NipunDilshanSenevirathne/Agnikarma-Device-Medi-/hardware/fabrication/P3R1/drill-report.txt

Drill report for agni-controller-carrier.kicad_pcb
Created on 2026-10-31T03:52:27

Copper Layer Stackup:
    =============================================================
    L1 :  F.Cu                      front
    L2 :  B.Cu                      back

Drill file 'agni-controller-carrier-PTH.drl' contains
    plated through holes:
    =============================================================
    T1  1.000mm  0.0394"  (160 holes))
    T2  1.300mm  0.0512"  (2 holes))

    Total plated holes count 162

Drill file 'agni-controller-carrier-NPTH.drl' contains
    unplated through holes:
    =============================================================
    T1  3.200mm  0.1260"  (4 holes))

    Total unplated holes count 4
