NipunDilshanSenevirathne/Agnikarma-Device-Medi-/docs/audit-sources.md

# Primary sources checked in the audit - 31 October 2026
- [Adafruit MAX31865 pinout and terminal guide](https://learn.adafruit.com/adafruit-max31865-rtd-pt100-amplifier/pinouts): four-wire terminal configuration and module supply/output distinction.
- [Adafruit OLED wiring guide](https://learn.adafruit.com/monochrome-oled-breakouts/wiring-128x64-oleds): current STEMMA QT auto-reset revision versus older reset-dependent hardware.
- [MicroPython 1.26 RP2 reference](https://docs.micropython.org/en/v1.26.0/rp2/quickref.html): target API context; no claim of target-board execution.

Other component, clinical and standards references are listed in sources.md. Catalogue/datasheet review does not establish whole-device safety or manufacturing correctness. Separate native CAD results are recorded in docs/records/native-cad-checks.json. Full licensed-standards assessment and physical tests have not been completed.
