NipunDilshanSenevirathne/Agnikarma-Device-Medi-/docs/delivery-status.md

# Delivery status 0.5.0

The folder now includes routed native carrier CAD, matching local libraries and schematic, native ERC/DRC/parity reports, candidate fabrication data, native board images, STEP and eight closed STL meshes. This closes the earlier absence of routing and native CAD checks for the **low-current carrier only**.

It does not close external circuit validation, fabrication/physical fit, real Pico execution, full cartridge construction, battery/charger selection, complete handheld packaging or medical release. Read [BUILD_COMPLETENESS](../BUILD_COMPLETENESS.md) and [engineering handover](engineering-handover.md). No physical test or approval is claimed as performed.
