NipunDilshanSenevirathne/Agnikarma-Device-Medi-/hardware/calculations/nichrome-arithmetic-NOT-a-winding-release.csv

Diameter_mm | Area_mm2 | Nominal_cold_length_mm | Wire_surface_cm2 | Full_on_surface_load_W_per_cm2_at_8p4V
0.15 | 0.017671 | 35.667 | 0.16808 | 190.821
0.2 | 0.031416 | 63.408 | 0.39841 | 80.503
0.25 | 0.049087 | 99.075 | 0.77814 | 41.217
0.3 | 0.070686 | 142.669 | 1.34462 | 23.853
0.35 | 0.096211 | 194.188 | 2.13521 | 15.021
0.4 | 0.125664 | 253.633 | 3.18725 | 10.063
