NipunDilshanSenevirathne/Agnikarma-Device-Medi-/hardware/calculations/power-envelope.csv

Voltage_V | Resistance_ohm | On_current_A | Full_on_power_W | Command_duty_limit | Actual_average_W_at_command_limit
6.2 | 1.98 | 3.1313 | 19.4141 | 0.5 | 9.7071
6.2 | 2.2 | 2.8182 | 17.4727 | 0.5 | 8.7364
6.2 | 2.42 | 2.562 | 15.8843 | 0.5 | 7.9421
7.4 | 1.98 | 3.7374 | 27.6566 | 0.5 | 13.8283
7.4 | 2.2 | 3.3636 | 24.8909 | 0.5 | 12.4455
7.4 | 2.42 | 3.0579 | 22.6281 | 0.5 | 11.314
8.4 | 1.98 | 4.2424 | 35.6364 | 0.5 | 17.8182
8.4 | 2.2 | 3.8182 | 32.0727 | 0.5 | 16.0364
8.4 | 2.42 | 3.4711 | 29.157 | 0.5 | 14.5785
8.5 | 1.98 | 4.2929 | 36.4899 | 0.5 | 18.2449
8.5 | 2.2 | 3.8636 | 32.8409 | 0.5 | 16.4205
8.5 | 2.42 | 3.5124 | 29.8554 | 0.5 | 14.9277
