NipunDilshanSenevirathne/Agnikarma-Device-Medi-/mechanical/exports/harness-clamp.stl

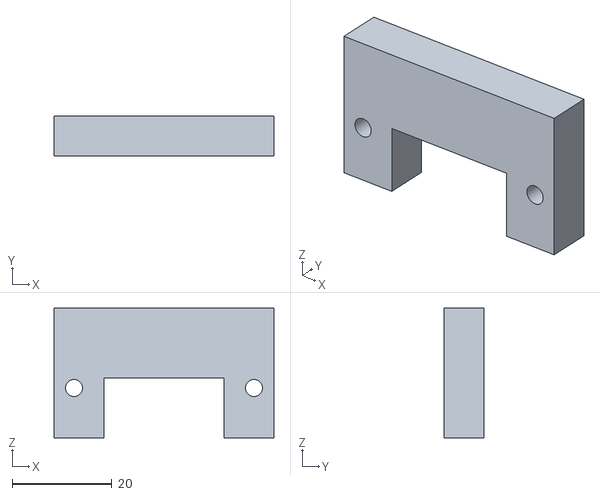
[picture p10: CAD file, 2026-10-30]
mechanical/exports/harness-clamp.stl
44.0 x 8.00 x 26.0
