NipunDilshanSenevirathne/Agnikarma-Device-Medi-/mechanical/exports/T03-shape.stl

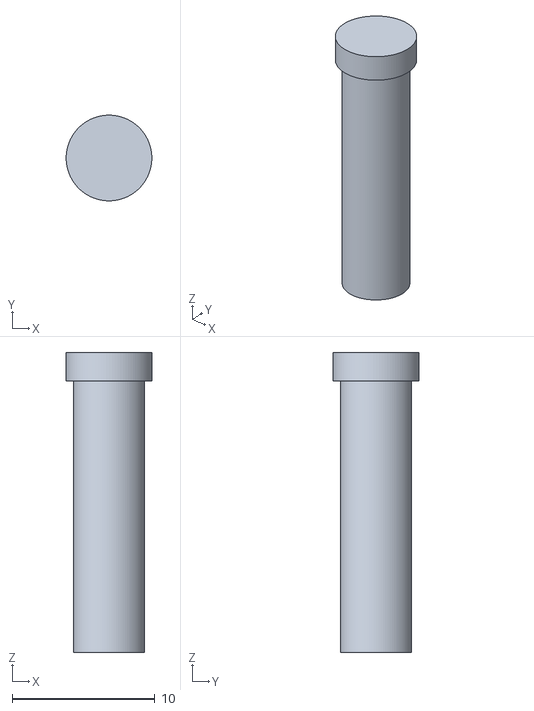
[picture p11: CAD file, 2026-10-30]
mechanical/exports/T03-shape.stl
6.00 x 6.00 x 21.0
