NipunDilshanSenevirathne/Agnikarma-Device-Medi-/mechanical/exports/T01-shape.stl

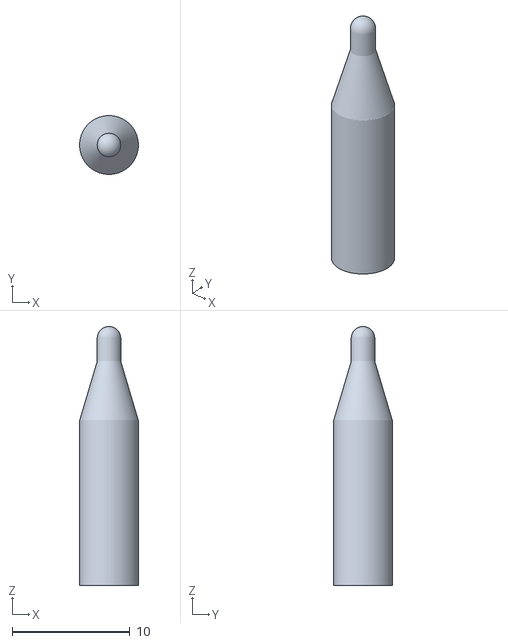
[picture p12: CAD file, 2026-10-30]
mechanical/exports/T01-shape.stl
5.00 x 5.00 x 22.0
