NipunDilshanSenevirathne/Agnikarma-Device-Medi-/mechanical/exports/T04-shape.stl

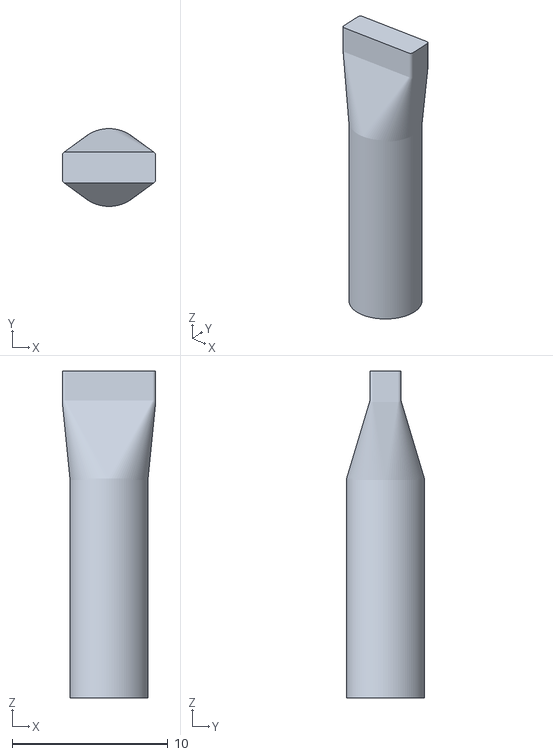
[picture p13: CAD file, 2026-10-30]
mechanical/exports/T04-shape.stl
6.00 x 5.00 x 21.0
