NipunDilshanSenevirathne/Agnikarma-Device-Medi-/mechanical/exports/carrier-board-only.step

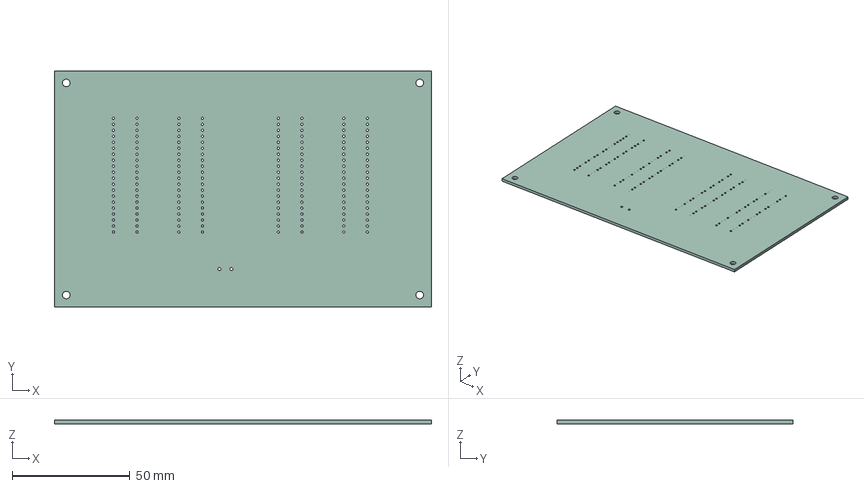
[picture p14: CAD file, 2026-10-30]
mechanical/exports/carrier-board-only.step
160.0 x 100.0 x 1.51 mm
