NipunDilshanSenevirathne/Agnikarma-Device-Medi-/mechanical/exports/T02-shape.stl

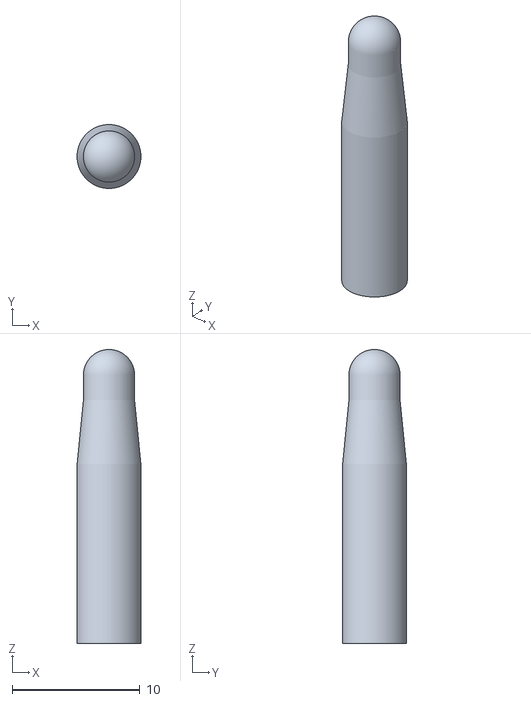
[picture p15: CAD file, 2026-10-30]
mechanical/exports/T02-shape.stl
5.00 x 5.00 x 23.0
