NipunDilshanSenevirathne/Agnikarma-Device-Medi-/mechanical/exports/controller-lid.stl

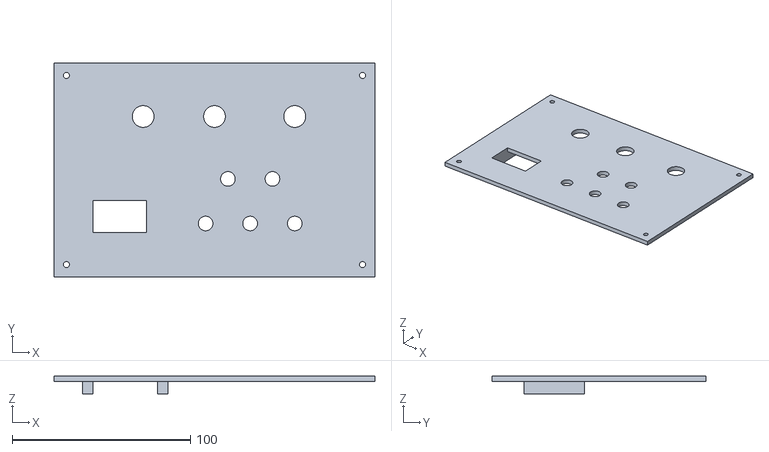
[picture p16: CAD file, 2026-10-30]
mechanical/exports/controller-lid.stl
180.0 x 120.0 x 10.0
