NipunDilshanSenevirathne/Agnikarma-Device-Medi-/mechanical/exports/T05-shape.stl

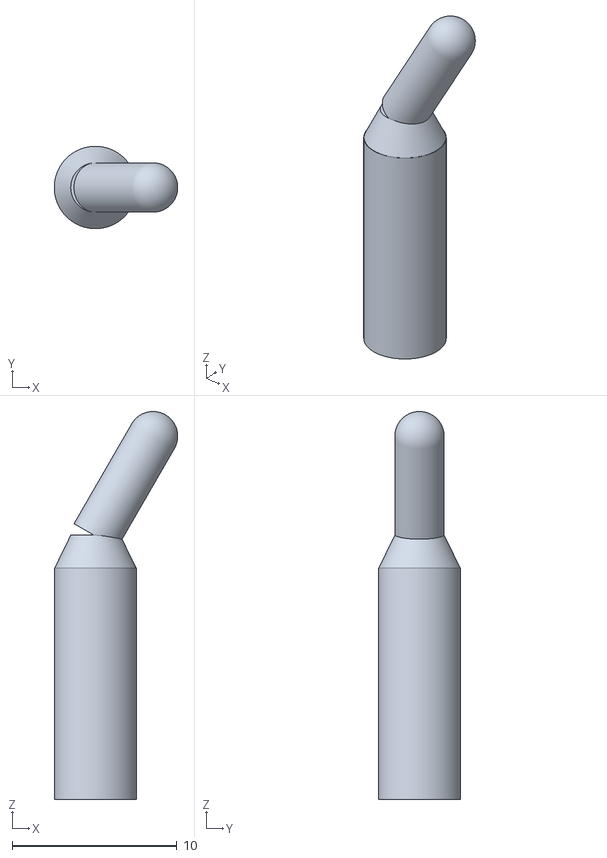
[picture p17: CAD file, 2026-10-30]
mechanical/exports/T05-shape.stl
7.50 x 5.00 x 23.6
