NipunDilshanSenevirathne/Agnikarma-Device-Medi-/mechanical/exports/controller-base.stl

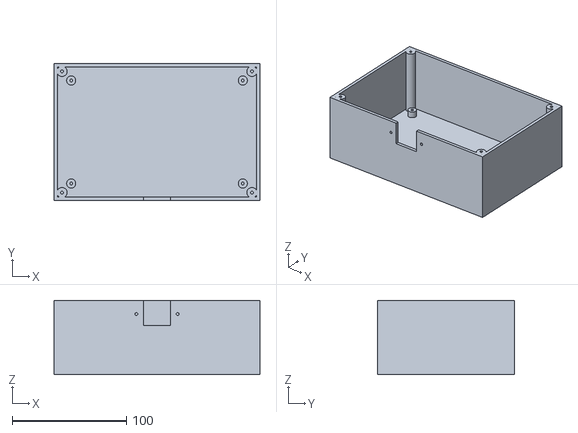
[picture p18: CAD file, 2026-10-30]
mechanical/exports/controller-base.stl
180.0 x 120.0 x 65.0
