NipunDilshanSenevirathne/Agnikarma-Device-Medi-/docs/images/terminal-wiring.png

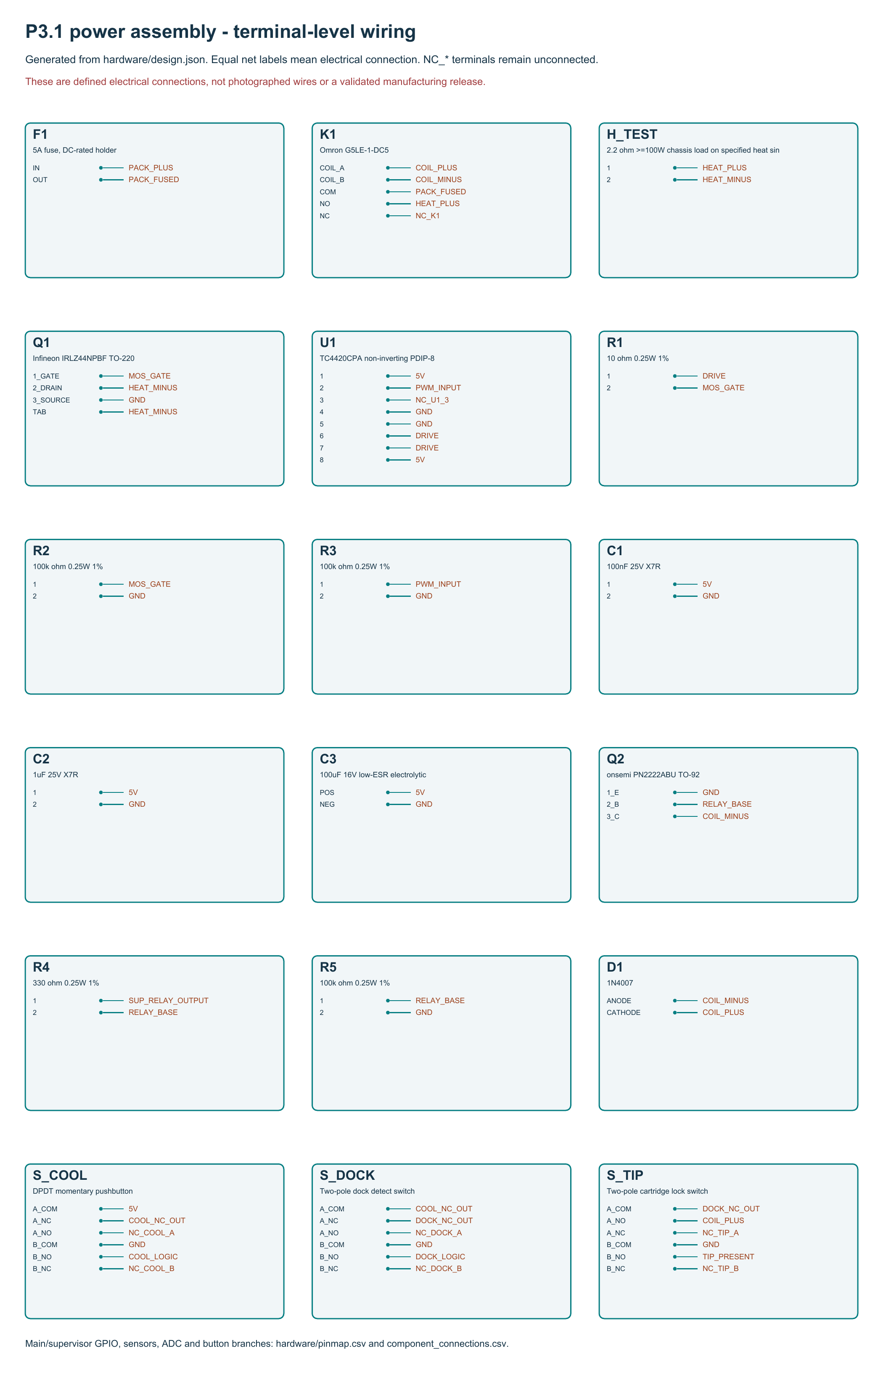
docs/images/terminal-wiring.png
