NipunDilshanSenevirathne/Agnikarma-Device-Medi-/docs/records/calibration-template.csv

record_id | date | unit_id | role | tip_id | reference_instrument | reference_calibration | point_C | indicated_C | reference_C | uncertainty_C | operator | disposition
UNMEASURED
