NipunDilshanSenevirathne/Agnikarma-Device-Medi-/docs/records/physical-test-template.csv

test_id | requirement | revision | setup | instruments | acceptance_criteria | measured_result | uncertainty | pass_fail | reviewer
NOT_EXECUTED
