NipunDilshanSenevirathne/Agnikarma-Device-Medi-/CHANGELOG.md

# Changelog
## Unreleased - CI diagnostics
- Print failed verification commands and captured child output directly in CI; keep UTF-8 diagnostic records.
- Preserve each matrix job's verification records as an Actions artifact and allow other matrix jobs to finish after a failure.
- Update checkout/setup actions to Node.js 24 versions and add a regression test for failure output and stop-on-failure behaviour.

## 0.5.0 - 2026-10-31
- Routed the low-current P3R1 carrier; added matched schematic, project-local libraries and connector/carrier BOM.
- Ran native KiCad 10.0.8: both ERCs, carrier DRC and schematic parity clean; exported Gerbers, separate plated/non-plated drills, PDFs, STEP and native PCB images.
- Added carrier-aligned enclosure mounts/lid/clamp, corrected tip shapes and compiled eight closed OpenSCAD meshes with recorded checks.
- Added reproducible power/divider/drive and wire-resistance calculations, current handover and fabrication instructions.
- Kept physical, supplier, handheld-integration and medical release work explicitly open.

## 0.4.0 - 2026-10-31
- Audited firmware, electrical records, tooling and manufacturing completeness.
- Required main permit for relay output; hardened provisioning and sensor transport; added early local shutdown checks.
- Added both RTD elements and full sensor/Pico terminal records; restricted OLED revision.
- Preserved commissioning records on deployment; removed duplicate manifests and private files from packaging.
- Added regression tests, procurement/net schedules, integrated build guide, audit report and one-command verification.

## 0.3.1 - 2026-10-31
- Reduced selectable presets to 50, 100, 150, 200 and 250 C; removed the 300 C button and GPIO/net records.
- Updated illustrations, electrical records, simulation and five-button enclosure source.
- Retained actual-temperature/fault monitoring in firmware; illustrated screen is a preset-selection view.

## 0.3.0 - 2026-10-30
- Added real dual-role MicroPython firmware, control/protocol/driver tests, simulation and role-specific deployment.
- Replaced the illustrative custom-small-board baseline with a concrete modular bench architecture and terminal/GPIO records.
- Added connected EDA source, net-assigned carrier starter, illustrated README, parametric CAD and actual host-check records.
- Preserved explicit physical/medical validation gaps. No production-ready hardware claim.

## 0.1 / 0.2
Research, concept renderings, functional block circuits, shape CAD and PCB floorplans. These are historical references and not the P3 assembly authority.
