NipunDilshanSenevirathne/Agnikarma-Device-Medi-/docs/risk-register.csv

ï»¿ID | Hazard | Harm | Causes | Proposed_controls | Evidence | Residual_risk_status
H01 | Heater runaway | Deep unintended burn | Q1 short; MCU freeze; sensor detachment | Independent temperature/gate; fault tests | Physical/supplier/clinical programme pending; see requirements_traceability.csv | OPEN - not accepted for manufacturing or patient use
H02 | 50 C command at high actual temperature | Unintended burn | Wrong selection decode or stale measurement | Independent setting-related cutoff | Physical/supplier/clinical programme pending; see requirements_traceability.csv | OPEN - not accepted for manufacturing or patient use
H03 | Residual heat | User/patient/transport burn | COOL mistaken for instant cold | Guarded cradle; measured indication; training | Physical/supplier/clinical programme pending; see requirements_traceability.csv | OPEN - not accepted for manufacturing or patient use
H04 | Brass chemical exposure | Tissue reaction/toxicity | Lead/other impurities; residues; corrosion | Alloy and finished-device evaluation | Physical/supplier/clinical programme pending; see requirements_traceability.csv | OPEN - not accepted for manufacturing or patient use
H05 | Cross infection | Infection | Unclean interface; failed sterilization | Validated process/sterile route | Physical/supplier/clinical programme pending; see requirements_traceability.csv | OPEN - not accepted for manufacturing or patient use
H06 | Battery fault | Burn/fire | Heat soak; short; charge fault | Qualified pack; separation; charge interlocks | Physical/supplier/clinical programme pending; see requirements_traceability.csv | OPEN - not accepted for manufacturing or patient use
H07 | Wrong/loose tip | Uncontrolled thermal contact | Misassembly; lock wear | Keyed lock/presence/identity | Physical/supplier/clinical programme pending; see requirements_traceability.csv | OPEN - not accepted for manufacturing or patient use
H08 | Excess contact | Excess tissue injury | Force/time variability | Clinical limits; usability; evaluate contact sensing | Physical/supplier/clinical programme pending; see requirements_traceability.csv | OPEN - not accepted for manufacturing or patient use
H09 | Cooling contamination | Infection | Airflow and dirty dock | Workflow and liner validation | Physical/supplier/clinical programme pending; see requirements_traceability.csv | OPEN - not accepted for manufacturing or patient use
H10 | Electrically live brass | Electrical injury | Insulation failure/charger coupling | Applied-part analysis and insulation tests | Physical/supplier/clinical programme pending; see requirements_traceability.csv | OPEN - not accepted for manufacturing or patient use
H11 | Fire/plume | Burn/inhalation harm | Fuel/oxygen/tissue destruction | Environment and plume controls | Physical/supplier/clinical programme pending; see requirements_traceability.csv | OPEN - not accepted for manufacturing or patient use
H12 | False cooled status | Handling burn | Sensor lag/dead battery/timeout | Conservative unknown status; physical guard | Physical/supplier/clinical programme pending; see requirements_traceability.csv | OPEN - not accepted for manufacturing or patient use
