NipunDilshanSenevirathne/Agnikarma-Device-Medi-/hardware/drawings/carrier-layers.pdf

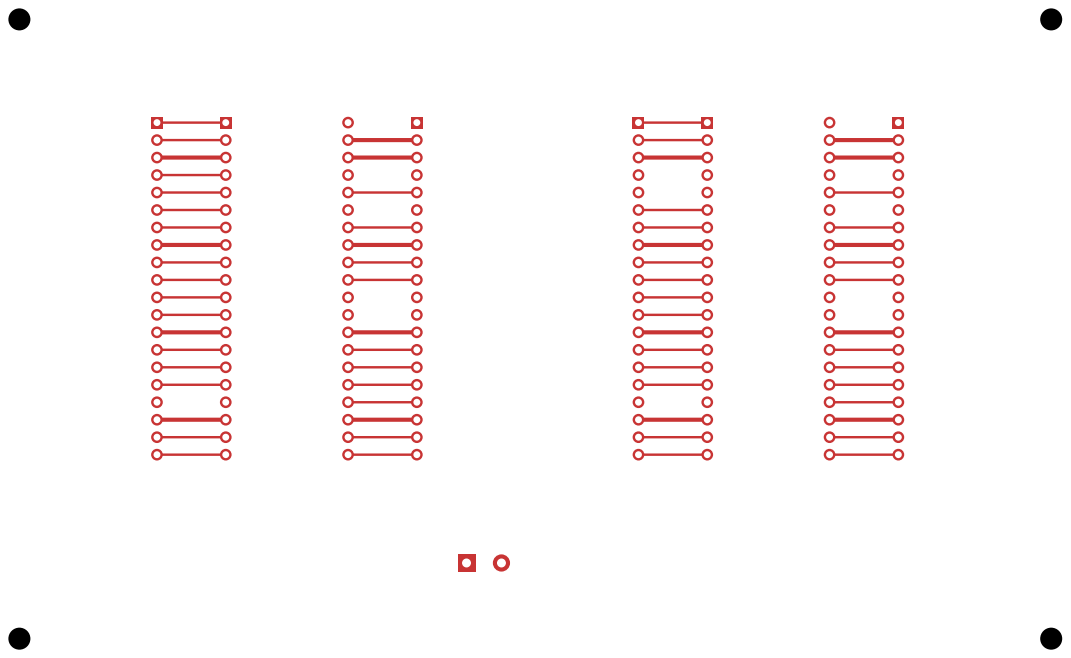
[picture p21: page 1]

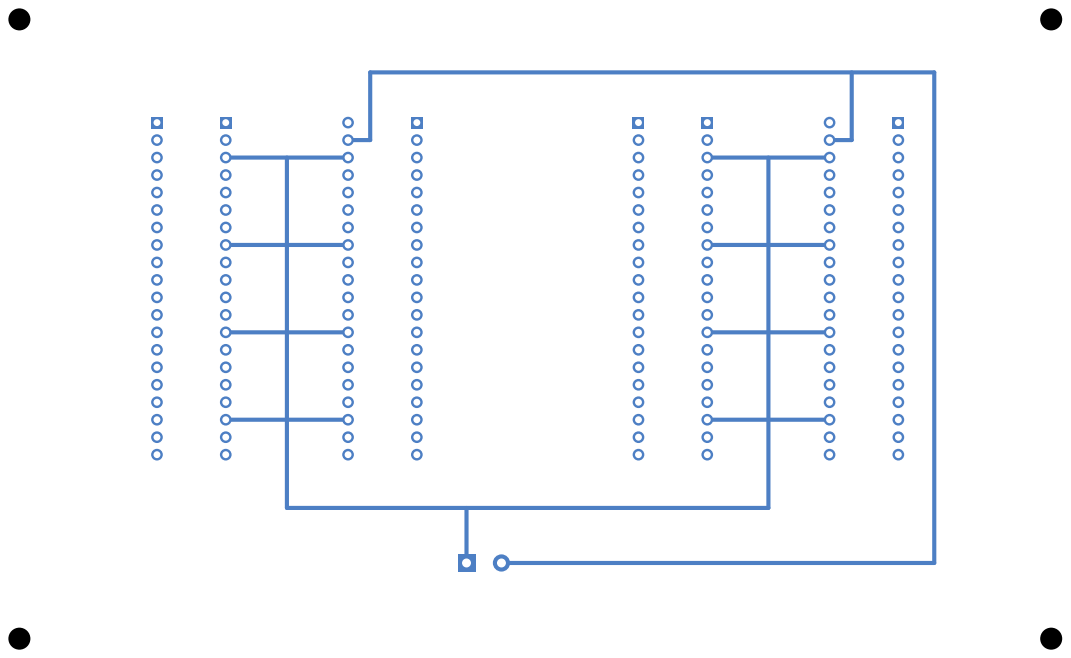
[picture p22: page 2]

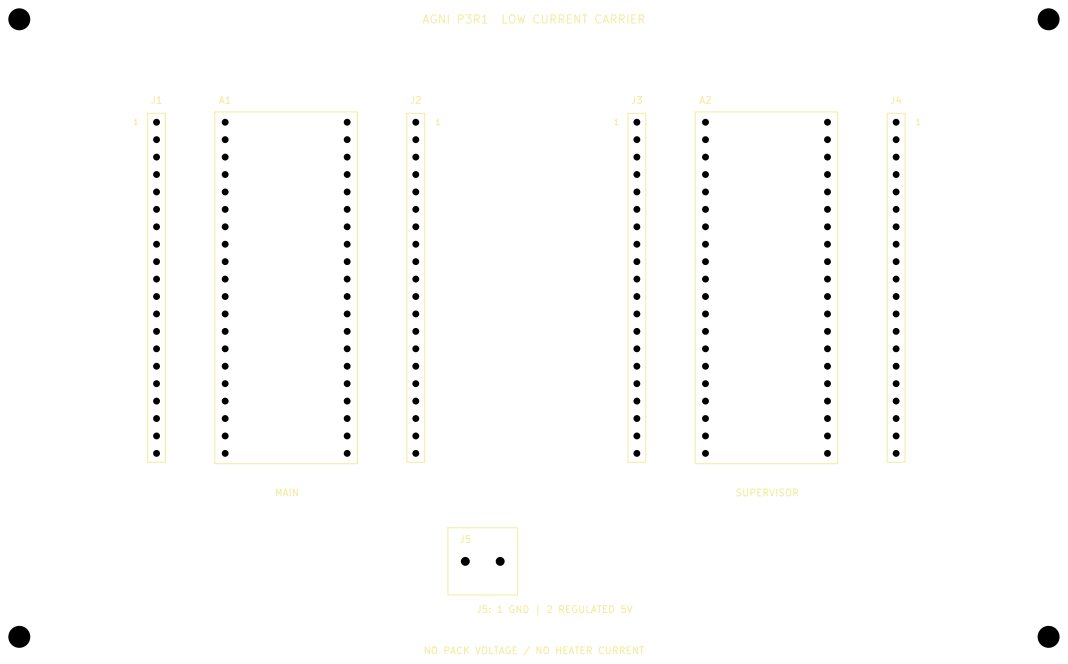
[picture p23: page 3]

AGNI P3R1 LOW CURRENT CARRIER

J5: 1 GND | 2 REGULATED 5V NO PACK VOLTAGE / NO HEATER CURRENT

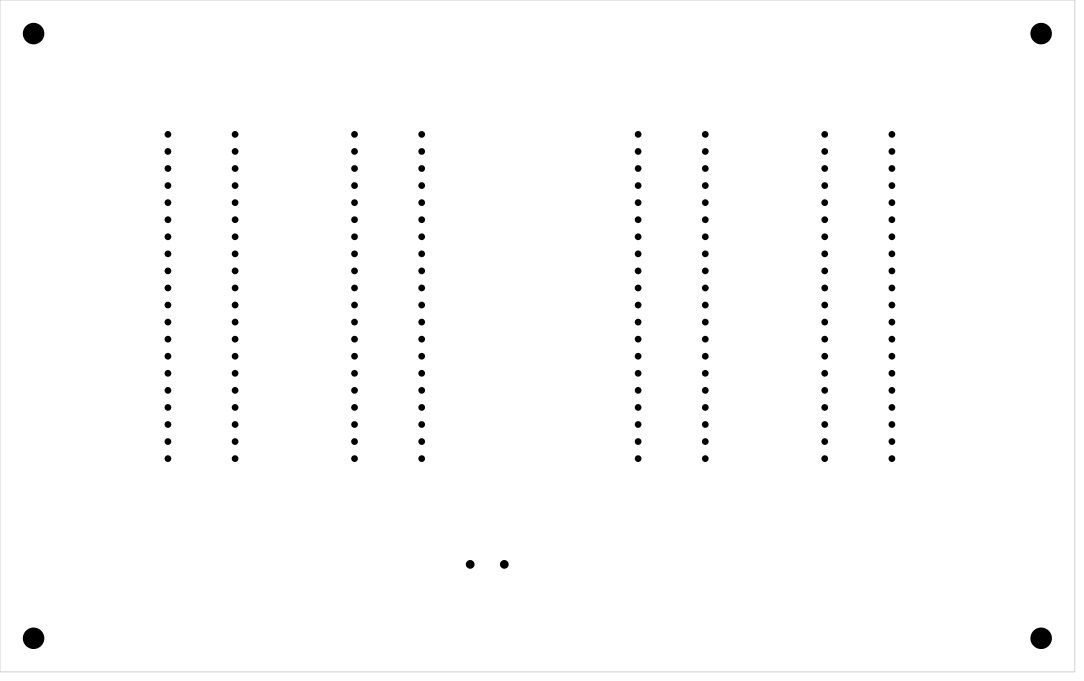
[picture p24: page 4]
