NipunDilshanSenevirathne/Agnikarma-Device-Medi-/hardware/drawings/carrier-schematic.pdf

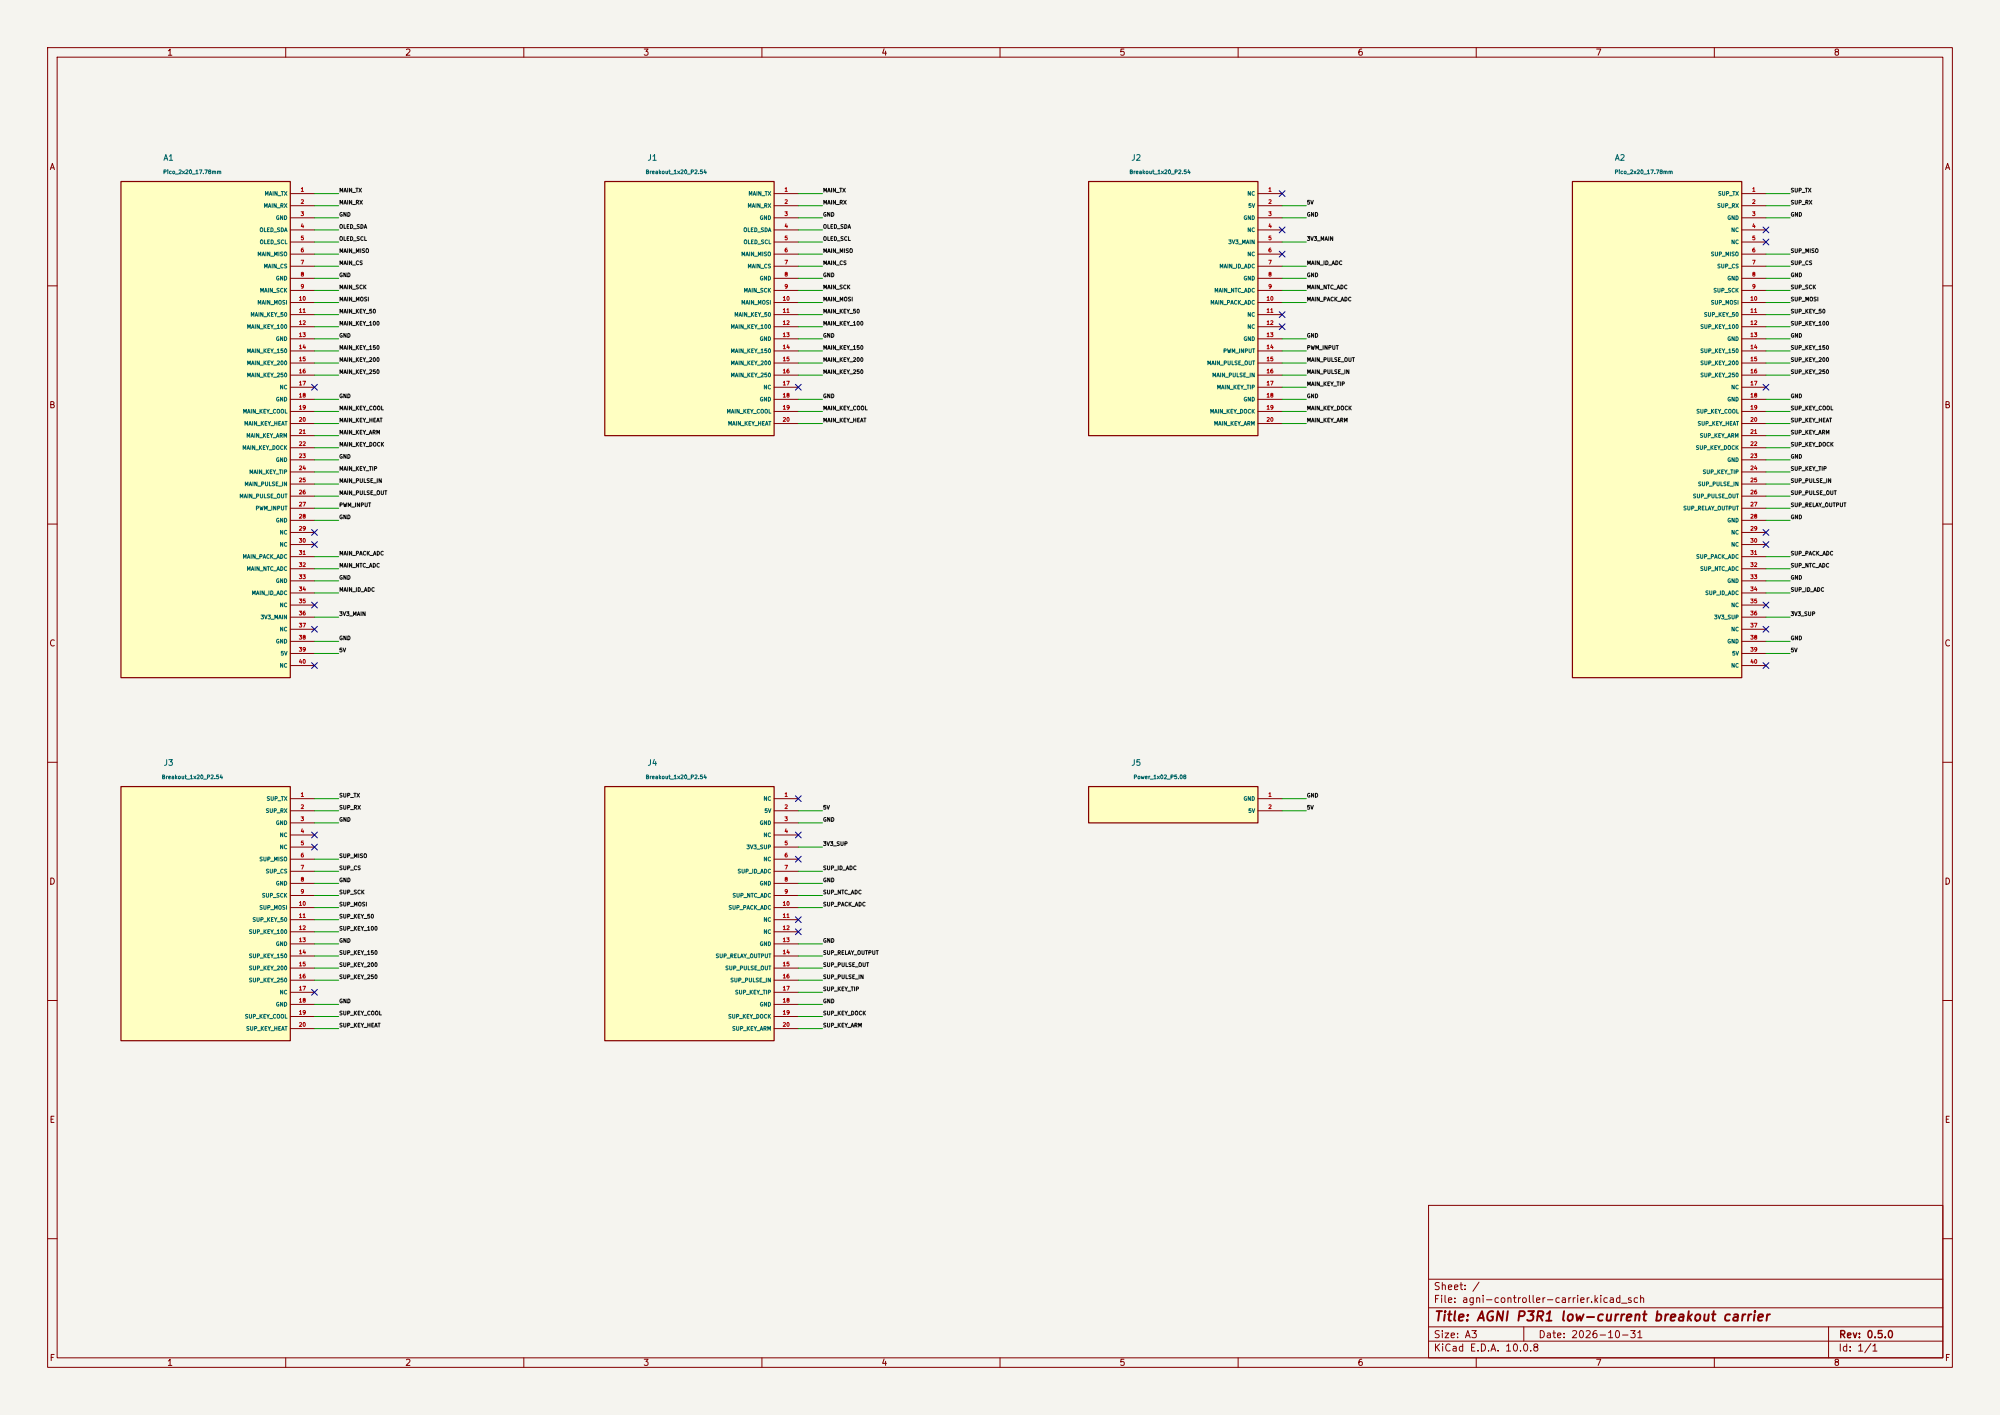
[picture p25: page 1]

Sheet: /
File: agni-controller-carrier.kicad_sch
Title: AGNI P3R1 low-current breakout carrier

Size: A3 | Rev: 0.5.0 | F Date: 2026-10-31
KiCad E.D.A. 10.0.8 | Id: 1/1
