NipunDilshanSenevirathne/Agnikarma-Device-Medi-/hardware/drawings/module-system-schematic.pdf

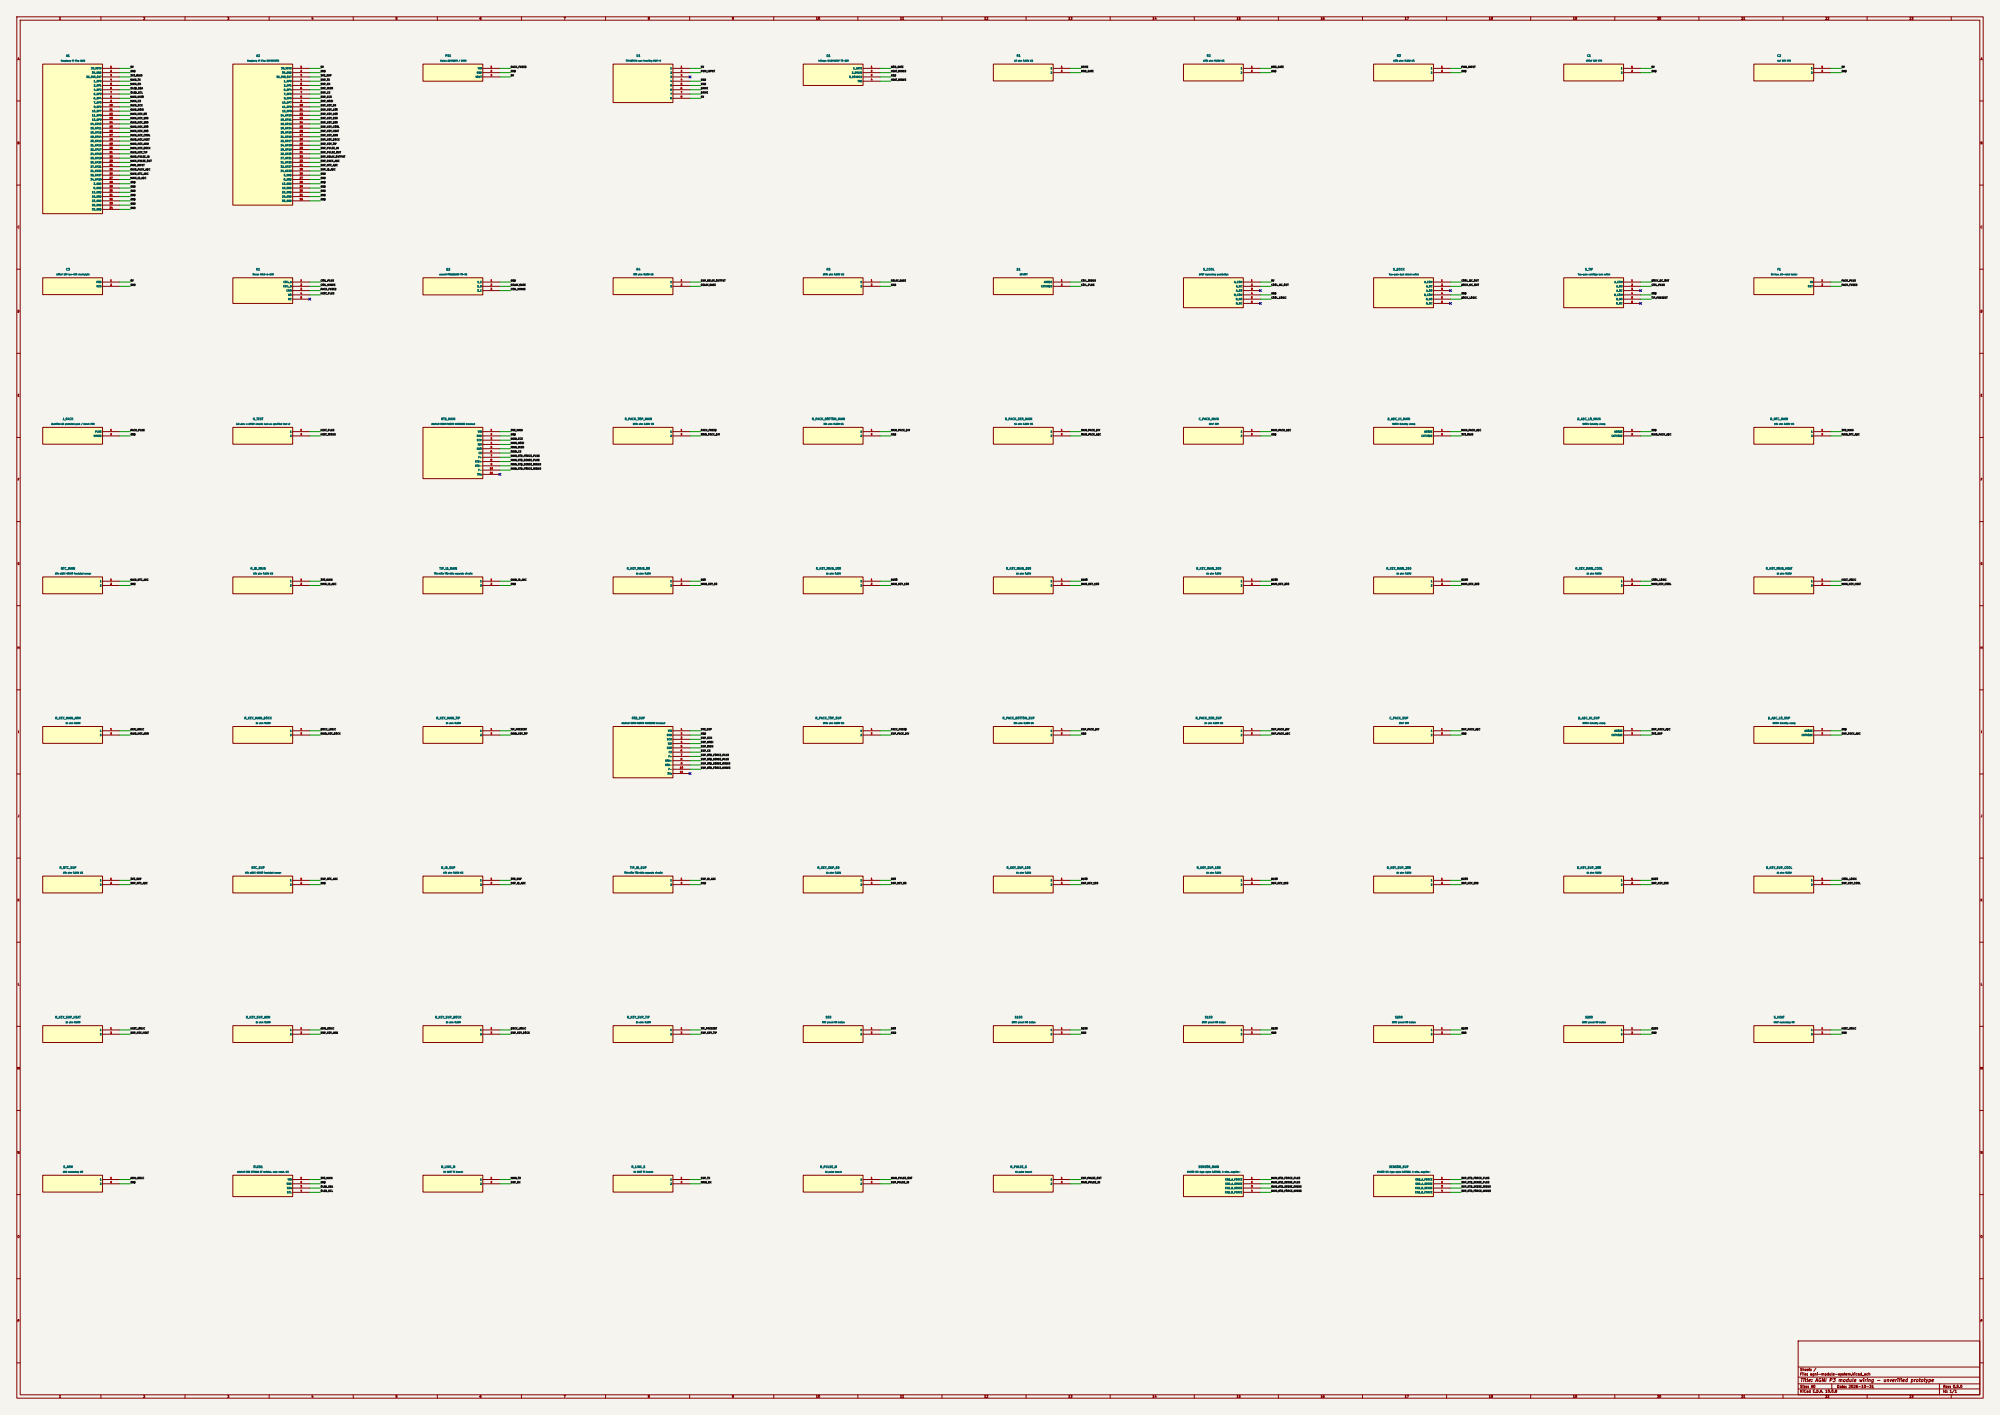
[picture p26: page 1]

Raspberry Pi Pico MAIN

Raspberry Pi Pico SUPERVISOR

Two-pole dock detect switch

Two-pole cartridge lock switch

5A fuse, DC-rated holder

Qualified 2S protected pack / bench PSU

2.2 ohm >=100W chassis load on specified heat si

Adafruit 326 STEMMA QT revision, auto-reset, I2C

Pt1000 IEC-type alpha 0.00385, 4-wire, supplier-

Sheet: /
File: agni-module-system.kicad_sch
Title: AGNI P3 module wiring - unverified prototype

Size: A0 | Rev: 0.5.0
KiCad E.D.A. 10.0.8 | Id: 1/1
