NipunDilshanSenevirathne/Agnikarma-Device-Medi-/hardware/kicad/agni-controller-carrier.kicad_pcb

## KiCad design hardware/kicad/agni-controller-carrier.kicad_pcb (2026-10-30)

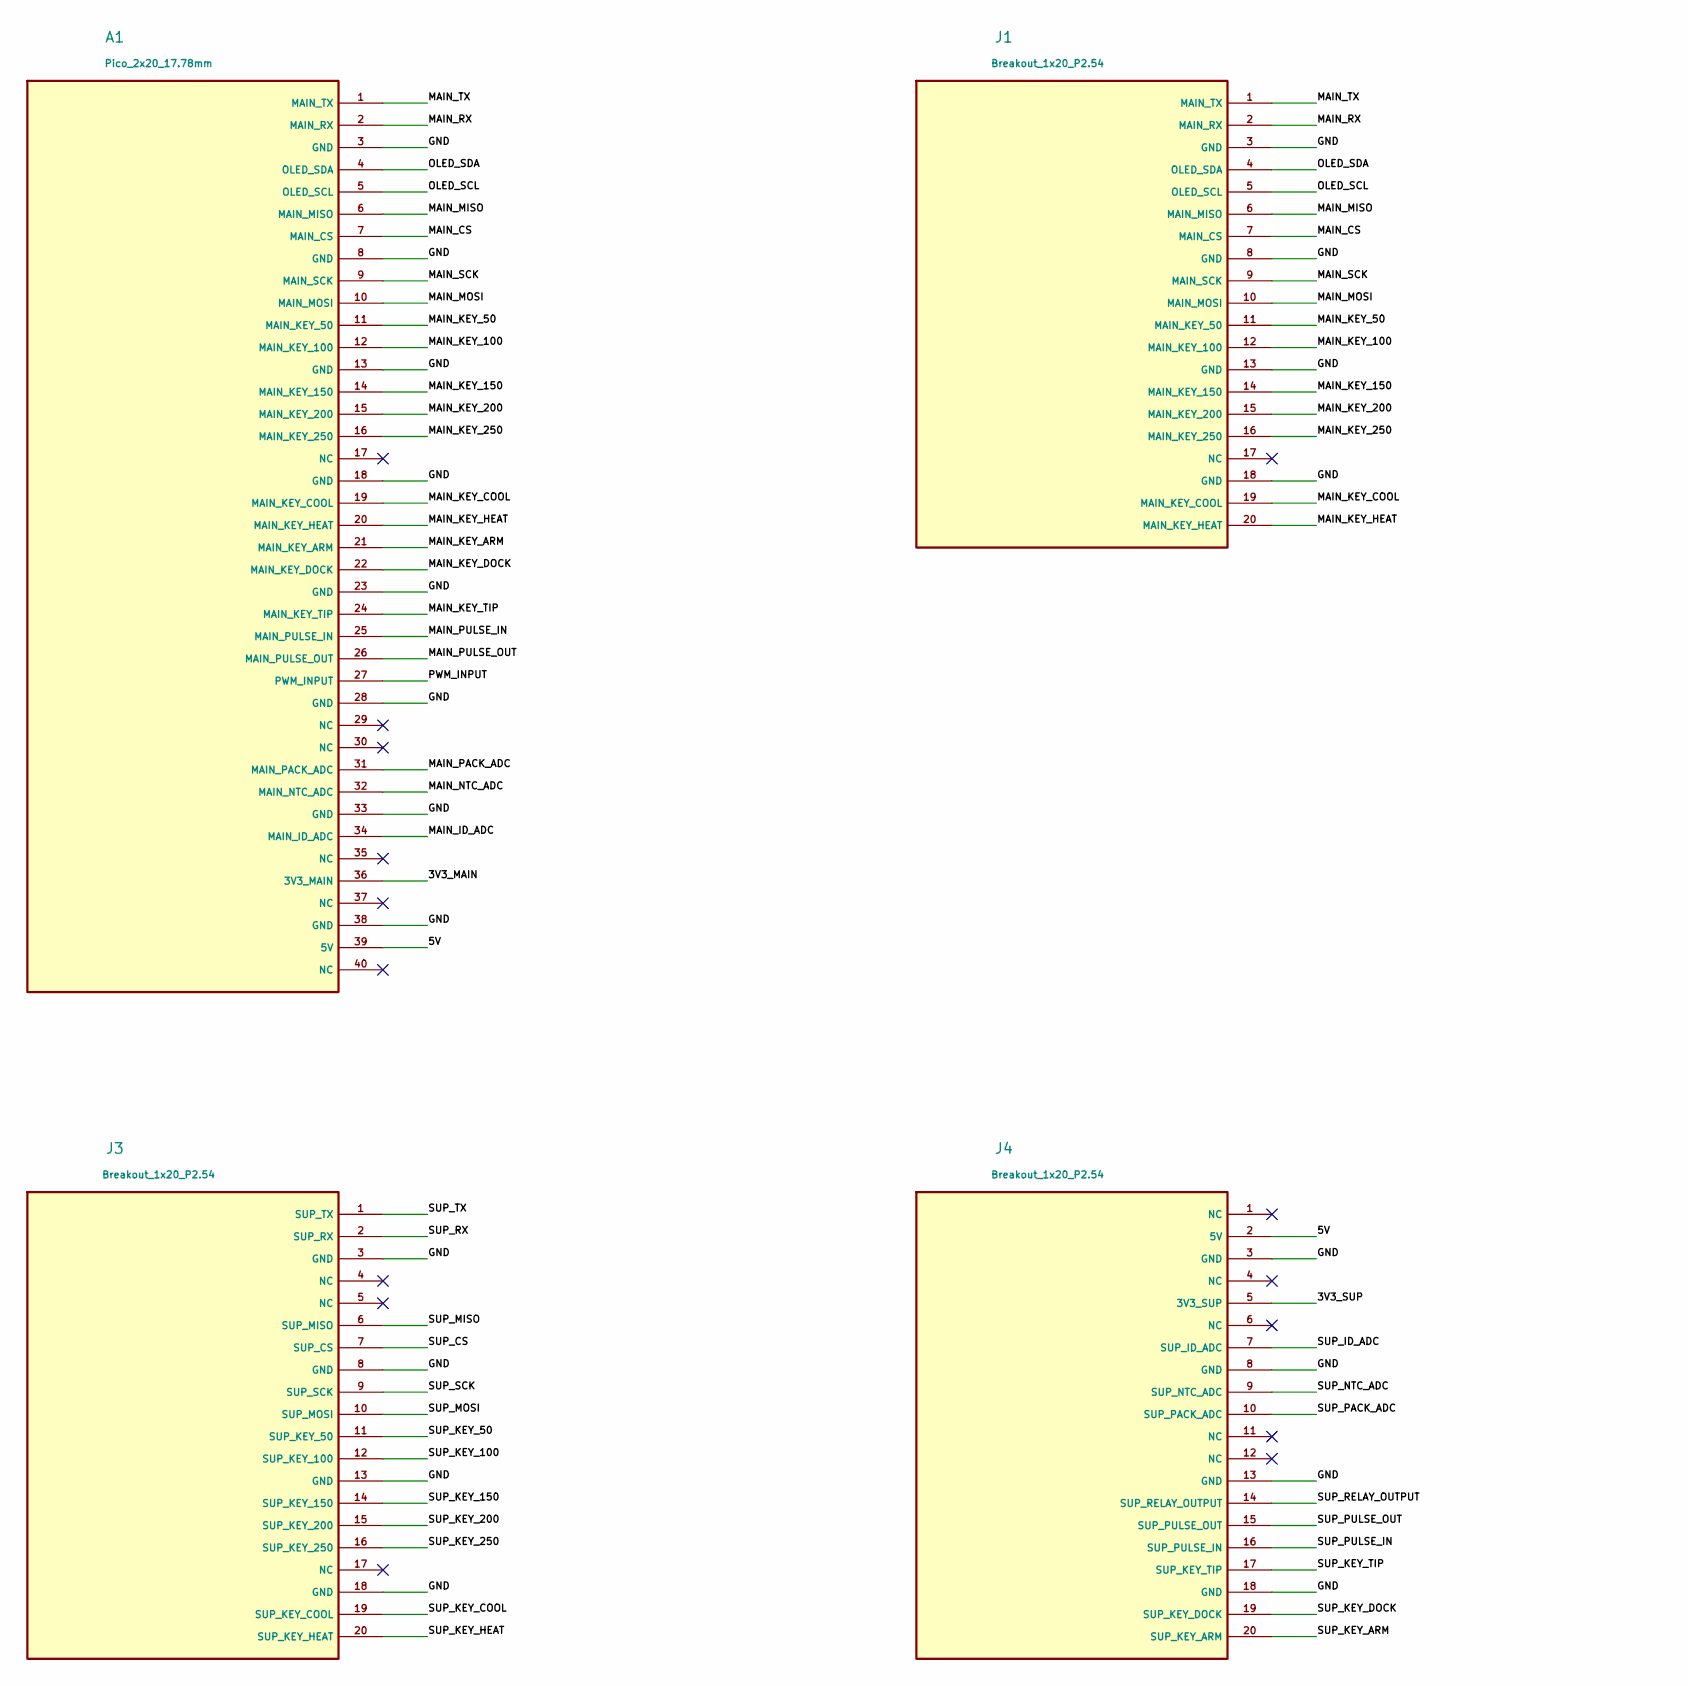
[picture p27: schematic agni-controller-carrier.kicad_sch, AGNI P3R1 low-current breakout carrier, part in row 1, column 1]

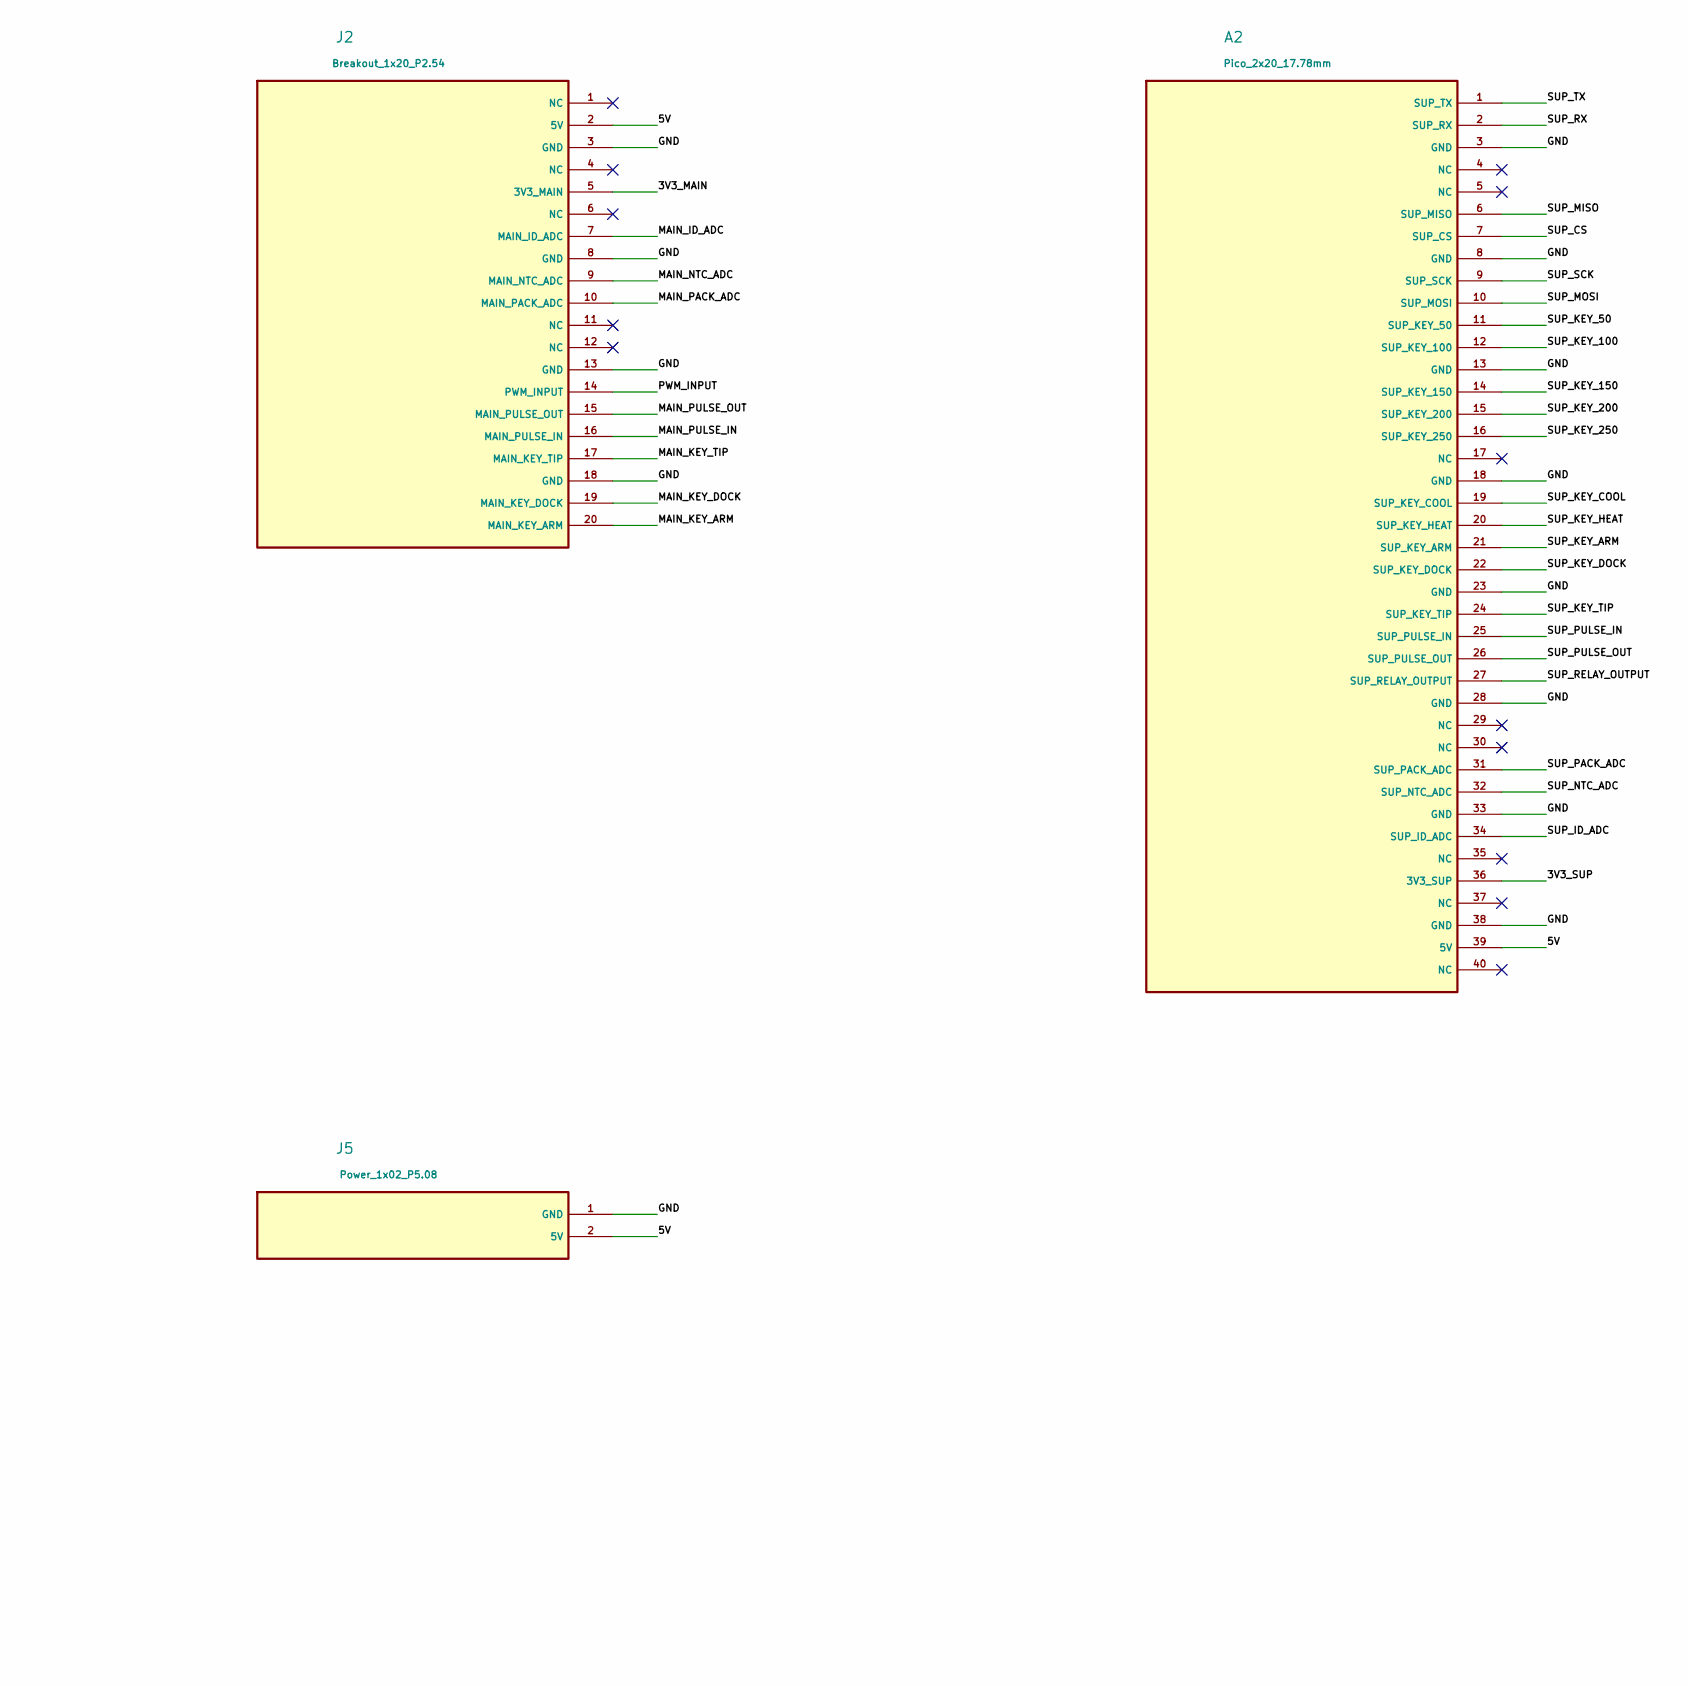
[picture p28: schematic agni-controller-carrier.kicad_sch, AGNI P3R1 low-current breakout carrier, part in row 1, column 2]

Parts:
A1, A2: Pico_2x20_17.78mm
J1, J2, J3, J4: Breakout_1x20_P2.54
J5: Power_1x02_P5.08

Connections:
/3V3_MAIN: A1.36 (3V3_MAIN), J2.5 (3V3_MAIN)
/3V3_SUP: A2.36 (3V3_SUP), J4.5 (3V3_SUP)
/5V: A1.39 (5V), A2.39 (5V), J2.2 (5V), J4.2 (5V), J5.2 (5V)
/GND: A1.3 (GND), A1.8 (GND), A1.13 (GND), A1.18 (GND), A1.23 (GND), A1.28 (GND), A1.33 (GND), A1.38 (GND), A2.3 (GND), A2.8 (GND), A2.13 (GND), A2.18 (GND), A2.23 (GND), A2.28 (GND), A2.33 (GND), A2.38 (GND), J1.3 (GND), J1.8 (GND), J1.13 (GND), J1.18 (GND), J2.3 (GND), J2.8 (GND), J2.13 (GND), J2.18 (GND), J3.3 (GND), J3.8 (GND), J3.13 (GND), J3.18 (GND), J4.3 (GND), J4.8 (GND), J4.13 (GND), J4.18 (GND), J5.1 (GND)
/MAIN_CS: A1.7 (MAIN_CS), J1.7 (MAIN_CS)
/MAIN_ID_ADC: A1.34 (MAIN_ID_ADC), J2.7 (MAIN_ID_ADC)
/MAIN_KEY_50: A1.11 (MAIN_KEY_50), J1.11 (MAIN_KEY_50)
/MAIN_KEY_100: A1.12 (MAIN_KEY_100), J1.12 (MAIN_KEY_100)
/MAIN_KEY_150: A1.14 (MAIN_KEY_150), J1.14 (MAIN_KEY_150)
/MAIN_KEY_200: A1.15 (MAIN_KEY_200), J1.15 (MAIN_KEY_200)
/MAIN_KEY_250: A1.16 (MAIN_KEY_250), J1.16 (MAIN_KEY_250)
/MAIN_KEY_ARM: A1.21 (MAIN_KEY_ARM), J2.20 (MAIN_KEY_ARM)
/MAIN_KEY_COOL: A1.19 (MAIN_KEY_COOL), J1.19 (MAIN_KEY_COOL)
/MAIN_KEY_DOCK: A1.22 (MAIN_KEY_DOCK), J2.19 (MAIN_KEY_DOCK)
/MAIN_KEY_HEAT: A1.20 (MAIN_KEY_HEAT), J1.20 (MAIN_KEY_HEAT)
/MAIN_KEY_TIP: A1.24 (MAIN_KEY_TIP), J2.17 (MAIN_KEY_TIP)
/MAIN_MISO: A1.6 (MAIN_MISO), J1.6 (MAIN_MISO)
/MAIN_MOSI: A1.10 (MAIN_MOSI), J1.10 (MAIN_MOSI)
/MAIN_NTC_ADC: A1.32 (MAIN_NTC_ADC), J2.9 (MAIN_NTC_ADC)
/MAIN_PACK_ADC: A1.31 (MAIN_PACK_ADC), J2.10 (MAIN_PACK_ADC)
/MAIN_PULSE_IN: A1.25 (MAIN_PULSE_IN), J2.16 (MAIN_PULSE_IN)
/MAIN_PULSE_OUT: A1.26 (MAIN_PULSE_OUT), J2.15 (MAIN_PULSE_OUT)
/MAIN_RX: A1.2 (MAIN_RX), J1.2 (MAIN_RX)
/MAIN_SCK: A1.9 (MAIN_SCK), J1.9 (MAIN_SCK)
/MAIN_TX: A1.1 (MAIN_TX), J1.1 (MAIN_TX)
/OLED_SCL: A1.5 (OLED_SCL), J1.5 (OLED_SCL)
/OLED_SDA: A1.4 (OLED_SDA), J1.4 (OLED_SDA)
/PWM_INPUT: A1.27 (PWM_INPUT), J2.14 (PWM_INPUT)
/SUP_CS: A2.7 (SUP_CS), J3.7 (SUP_CS)
/SUP_ID_ADC: A2.34 (SUP_ID_ADC), J4.7 (SUP_ID_ADC)
/SUP_KEY_50: A2.11 (SUP_KEY_50), J3.11 (SUP_KEY_50)
/SUP_KEY_100: A2.12 (SUP_KEY_100), J3.12 (SUP_KEY_100)
/SUP_KEY_150: A2.14 (SUP_KEY_150), J3.14 (SUP_KEY_150)
/SUP_KEY_200: A2.15 (SUP_KEY_200), J3.15 (SUP_KEY_200)
/SUP_KEY_250: A2.16 (SUP_KEY_250), J3.16 (SUP_KEY_250)
/SUP_KEY_ARM: A2.21 (SUP_KEY_ARM), J4.20 (SUP_KEY_ARM)
/SUP_KEY_COOL: A2.19 (SUP_KEY_COOL), J3.19 (SUP_KEY_COOL)
/SUP_KEY_DOCK: A2.22 (SUP_KEY_DOCK), J4.19 (SUP_KEY_DOCK)
/SUP_KEY_HEAT: A2.20 (SUP_KEY_HEAT), J3.20 (SUP_KEY_HEAT)
/SUP_KEY_TIP: A2.24 (SUP_KEY_TIP), J4.17 (SUP_KEY_TIP)
/SUP_MISO: A2.6 (SUP_MISO), J3.6 (SUP_MISO)
/SUP_MOSI: A2.10 (SUP_MOSI), J3.10 (SUP_MOSI)
/SUP_NTC_ADC: A2.32 (SUP_NTC_ADC), J4.9 (SUP_NTC_ADC)
/SUP_PACK_ADC: A2.31 (SUP_PACK_ADC), J4.10 (SUP_PACK_ADC)
/SUP_PULSE_IN: A2.25 (SUP_PULSE_IN), J4.16 (SUP_PULSE_IN)
/SUP_PULSE_OUT: A2.26 (SUP_PULSE_OUT), J4.15 (SUP_PULSE_OUT)
/SUP_RELAY_OUTPUT: A2.27 (SUP_RELAY_OUTPUT), J4.14 (SUP_RELAY_OUTPUT)
/SUP_RX: A2.2 (SUP_RX), J3.2 (SUP_RX)
/SUP_SCK: A2.9 (SUP_SCK), J3.9 (SUP_SCK)
/SUP_TX: A2.1 (SUP_TX), J3.1 (SUP_TX)

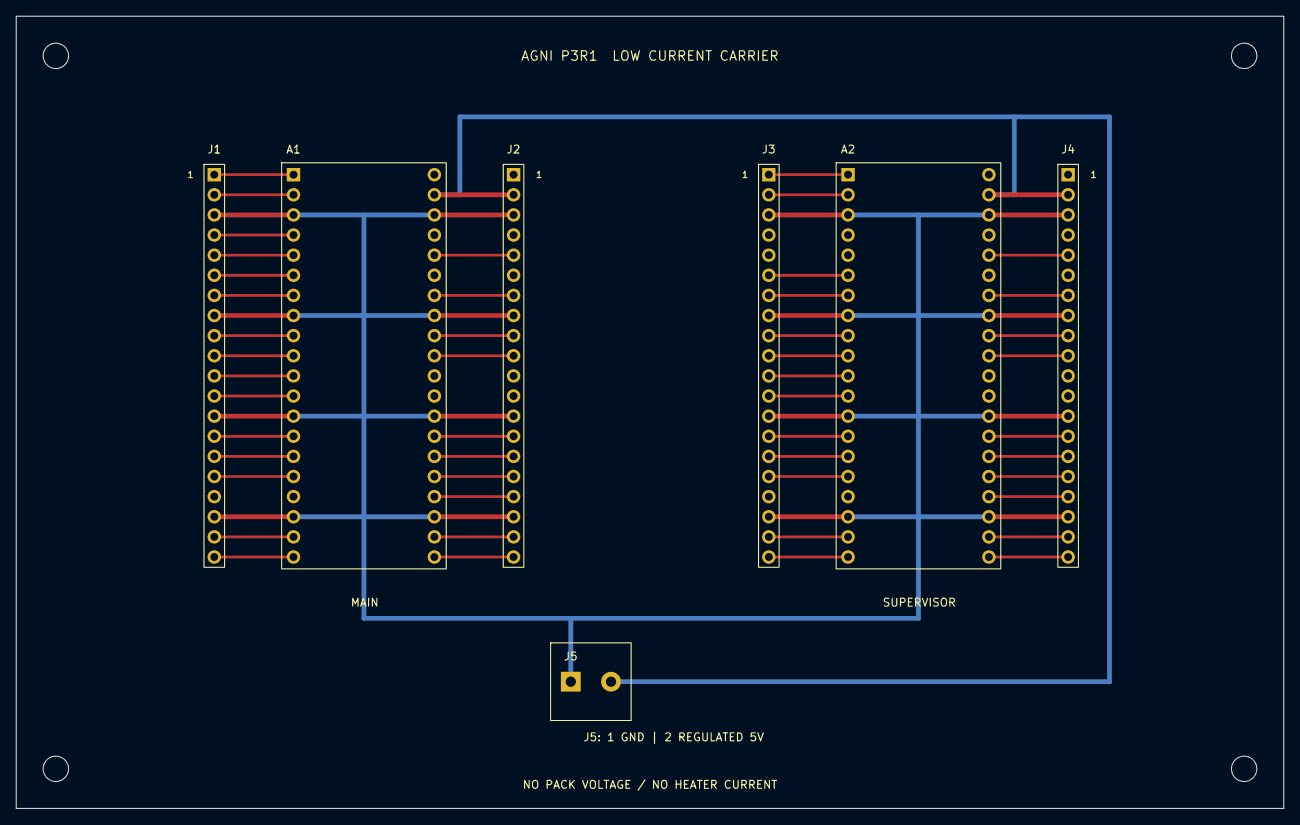
[picture p29: board agni-controller-carrier.kicad_pcb from above]

Board: 2 copper layers, 160.0 x 100.0 mm, 11 parts (0 on the bottom side), 50 nets.

Other parts of the board:
H1, H2, H3, H4: MountingHole_3.2mm
