NipunDilshanSenevirathne/Agnikarma-Device-Medi-/tests/test_tooling_audit.py

"""Exercise actual deployment/packaging scripts on isolated workspace fixtures."""
import unittest,tempfile,subprocess,sys,json,zipfile,shutil
from pathlib import Path
ROOT=Path(__file__).resolve().parents[1]
class ToolingAuditTests(unittest.TestCase):
    def setUp(self):
        base=ROOT/'build/tool-tests';base.mkdir(parents=True,exist_ok=True)
        self.tmp=tempfile.TemporaryDirectory(dir=str(base));self.work=Path(self.tmp.name).resolve()
        self.work.relative_to(base.resolve())
    def tearDown(self):self.tmp.cleanup()
    def command(self,*args):
        r=subprocess.run([sys.executable,*map(str,args)],cwd=ROOT,capture_output=True,text=True)
        self.assertEqual(r.returncode,0,r.stdout+r.stderr);return r
    def test_deploy_preserves_existing_provisioning_unless_reset(self):
        self.command(ROOT/'tools/deploy.py','main','--out',self.work)
        p=self.work/'main/provision.json';cfg=json.loads(p.read_text());cfg['calibration_record']='RETAIN-ME';p.write_text(json.dumps(cfg))
        self.command(ROOT/'tools/deploy.py','main','--out',self.work)
        self.assertEqual(json.loads(p.read_text())['calibration_record'],'RETAIN-ME')
        self.command(ROOT/'tools/deploy.py','main','--out',self.work,'--reset-provision')
        self.assertFalse(json.loads(p.read_text())['bench_enabled'])
    def test_package_has_no_duplicate_manifest_or_private_files(self):
        fixture=self.work/'repo';(fixture/'tools').mkdir(parents=True)
        shutil.copy2(ROOT/'tools/package.py',fixture/'tools/package.py')
        for name,body in [('README.md','fixture'),('SOURCE_MANIFEST.json','old'),('provision.json','private'),('.env','private'),('signing.key','private'),('board.kicad_prl','local CAD preference')]:
            (fixture/name).write_text(body)
        archive=self.work/'out.zip';self.command(fixture/'tools/package.py','--out',archive)
        with zipfile.ZipFile(archive) as z:
            names=z.namelist();self.assertEqual(len(names),len(set(names)))
            self.assertEqual(names.count('agni-karma/SOURCE_MANIFEST.json'),1)
            self.assertFalse(any(x.endswith(('provision.json','.env','signing.key','.kicad_prl')) for x in names))
    def test_verifier_exposes_child_failure_and_preserves_diagnostics(self):
        fixture=self.work/'verifier';(fixture/'tools').mkdir(parents=True)
        shutil.copy2(ROOT/'tools/verify.py',fixture/'tools/verify.py')
        (fixture/'VERSION').write_text('0.0.0\n',encoding='utf-8')
        failed="import sys; print('stdout failure detail'); print('stderr failure detail',file=sys.stderr); sys.exit(7)"
        later="from pathlib import Path; Path('should-not-run').write_text('bad')"
        code="from tools import verify; verify.COMMANDS="+repr([['-c',failed],['-c',later]])+"; verify.main()"
        result=subprocess.run([sys.executable,'-c',code],cwd=fixture,capture_output=True,text=True,encoding='utf-8')
        self.assertEqual(result.returncode,1,result.stdout+result.stderr)
        for detail in ('FAILED (exit 7): python -c','stdout failure detail','stderr failure detail'):
            self.assertIn(detail,result.stdout)
        record=json.loads((fixture/'docs/records/verification.json').read_text(encoding='utf-8'))
        self.assertIs(record['passed'],False)
        self.assertEqual([c['exit_code'] for c in record['commands']],[7])
        self.assertIn('stderr failure detail',(fixture/'docs/records/host-checks.txt').read_text(encoding='utf-8'))
        for name in ('host-checks.txt','verification.json'):
            self.assertNotIn(b'\r\n',(fixture/'docs/records'/name).read_bytes())
        self.assertFalse((fixture/'should-not-run').exists())
